YILINUMICH/SRFM/firmware/variants/Seeed_XIAO_nRF52840/README.md

Board variant for the Seeed XIAO nRF52840, copied unchanged from
Seeed-Studio/Adafruit_nRF52_Arduino (`firmware/variants/Seeed_XIAO_nRF52840`, core 1.1.13).

PlatformIO's nordicnrf52 platform has no XIAO definition and its Adafruit
core package has no XIAO variant, so the pin map lives here and
`firmware/boards/xiao_nrf52840.json` points `build.variants_dir` at this directory.
