YILINUMICH/SRFM/hardware/SRFM_PCB/Gerber_V1.1_2026-09-11/How-to-order-PCB.txt

How to Order PCB

Please refer to:
https://prodocs.easyeda.com/en/pcb/order-order-pcb/index.html
