YILINUMICH/SRFM/(commit log)

2026-08-12 Initial commit: Mega 2560 + LTC2668 EVM pressure/vacuum regulator controller
    - Self-contained LTC2668 SPI driver (±10V SoftSpan, SDO echo verification)
    - PressureControl layer mapping 1 air + 3 vacuum regulators to DAC ch 0-3
    - Serial command protocol (ID/P/V/CAL/GET/ZERO) at 115200 baud
    - tkinter GUI over pyserial with per-regulator sliders and ZERO ALL
    - README + HANDOFF docs; DC2025A datasheet/manual PDFs in lib/LTC2668
2026-08-12 Set real regulator calibrations: ITV0030-3BL (air) and ITV2090-312L5 (vacuum)
    Both take 0-10 VDC command signals. Air: +1..+500 kPa; vacuum: -1.3..-80 kPa
    per SMC datasheets. Updated firmware defaults, GUI slider ranges, and docs.
2026-08-12 Fix DAC span mismatch and add raw-DAC debug commands
    The firmware programmed the +/-10V SoftSpan while the board's MSPx
    jumpers (JP4 = 0) lock the LTC2668 into a fixed 0-10V span, so the span
    command was silently ignored and every output landed 1.5x high: a
    commanded 5V measured 7.5V. The boot "safe state" was worse than
    cosmetic -- setVoltageAll(0.0) computed mid-scale code 32767, driving
    all 16 channels to ~5V and commanding the air regulator to ~250 kPa on
    every reset and reflash.
    Switch to LTC2668_SPAN_0_TO_10V. That is the span the jumpers select and
    the input both regulator models accept (ITV0030-3BL and ITV2090-312L5
    are both 0-10V types, per the -3.. suffix). Code 0 is now a true 0V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
    [main.cpp]
2026-08-12 GUI: drop sliders, stack panels, add presets and voltage entry
    Reworks the control panel around bench use rather than dragging:
    - Remove the sliders. Imprecise for setting a pressure and they needed
    drag-throttling to avoid flooding the serial port.
    - One panel per row instead of a 2x2 grid, so each panel is full width
    and the range line is readable. Ranges print in calibration order
    (value at 0V, then at 10V) rather than sorted, so the vacuum ranges
    read -1.3 .. -80 kPa directly against the DAC voltage beside them.
    - Preset buttons per regulator, labelled with unit and the command
    voltage the firmware will program. The voltage comes from a
    voltage_for() that mirrors setPressu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
    [pressure_gui.py]
2026-08-12 README: correct the jumper table and document the raw DAC commands
    JP4 (MSP2) is 0, not 1, so the MSPx pins are not all 1 and the part is
    not in SoftSpan — it is in a fixed manual span where SPI span commands
    have no effect on the hardware. The table said the opposite, and the
    paragraph under it warned about exactly the condition the board is
    actually in.
    Record the span as established by measurement rather than by decoding
    the jumpers: a commanded 5V measured 7.5V at VOUT0, which is only
    consistent with a 0–10V span. Note the trap that follows from fixed
    mode, where SPAN silently changes only the driver's conversion math.
    Also bring the protocol section up to date with the firmware: s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
2026-08-12 GUI: run long-duration tests from a JSON profile
    Adds a Script… button that loads a JSON test profile and steps through it
    unattended, so a multi-hour soak can be defined once and replayed instead
    of being clicked out by hand.
    A profile is a list of steps, each holding a set of setpoints for a given
    number of seconds, optionally repeated. A step entry addresses either the
    pressure layer ({"reg": 0-3, "kPa": ...}) or a DAC channel directly
    ({"ch": 0-15, "volts": ...}), so raw channels can be driven in the same
    sequence. Two examples ship in gui/profiles/.
    Design notes:
    - The whole file is validated before the run starts, setpoints included
    and checked against each regulator's calibrate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
2026-08-12 GUI: document the profile format, fix reader-thread crash on close
    Running quick_check.json against the Mega surfaced a shutdown bug that
    predates the profile work: closing the port while the reader thread is
    blocked in readline() dumps a traceback.
    pyserial's win32 backend tears down _overlapped_read as close() runs on
    the main thread, so the in-flight read raises AttributeError from inside
    pyserial rather than the SerialException the loop was catching. Catch it,
    and add a _closing flag so the thread exits quietly on a deliberate
    disconnect instead of racing the teardown.
    Also coalesce status refreshes. Every P/V ack queued its own GET, so a
    profile step setting four regulators produced f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
    [pressure_gui.py]
2026-08-12 README: add a Deployment section with the setup commands
    The README explained the hardware well but never said, in one place, how
    to go from a checkout to something running. Adds a Deployment section
    after the DAC channel assignment covering the four steps in order:
    install the tools, build and flash, confirm over the monitor, start the
    GUI.
    Folds in the old Build & flash section rather than leaving two places
    that say how to compile, and drops the duplicate pip line from the GUI
    section so installation is documented once.
    Includes the two traps that actually cost time on this bench: a
    charge-only USB cable enumerates nothing and looks exactly like a dead
    Mega, and the serial monitor has t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
2026-08-12 GUI: per-valve CLEAR button, copyright line
    CLEAR sits next to Set on each panel and drops that one regulator to
    zero, resetting its entries, so a single channel can be released without
    disturbing the other three. It sends the same 0 kPa setpoint as ZERO ALL
    and lets the firmware clamp to the safe end of the range.
    Also adds the project copyright in the bottom-right corner.
    [pressure_gui.py]
2026-08-13 GUI: lay the four regulator panels out side by side
    They were stacked one per row, which made a tall window with a lot of
    empty space either side. Put them in a single row of four columns and
    narrow each panel to suit: presets wrap after three buttons, and the
    range header and the commanded/DAC readback each take two lines rather
    than one wide one. Everything else spans the full width.
    Renders at 1224x577, so it still fits a 1366-wide screen.
2026-09-10 Custom PCB firmware: XIAO nRF52840 + AD5724R DAC + ADS1015 ADC
    New branch for the custom 4-channel valve controller board described in
    FIRMWARE_HANDOFF.md, replacing the Mega 2560 + LTC2668 EVM stack on main.
    Firmware (src/, lib/):
    - AD5724R SPI driver: 24-bit frames, mode 2 (switchable), register readback
    - ADS1015 I2C driver: single-shot, averaged monitor reads with timeout
    - ValveConfig: channel map, code_full_scale, readback gain/enable, pressure
    endpoints, heartbeat timeout and SPI mode in internal flash (CRC, version)
    - main.cpp: boot order from the handoff (CLR release, power-up, range,
    readback proof before the rail), nRF52 watchdog, host heartbeat, eFuse
    FLT latch handling, p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
2026-09-10 Board JSON: add XIAO nRF52840 Sense USB IDs (0x8045/0x0045) so upload auto-detects the port
    Claude-Session: https://claude.ai/code/session_01KaDQVFmY1fveNB5y8a6ZE5
2026-09-10 Bench bring-up: verified channel map, watchdog-safe DFU entry, RAWGET/DFU commands
    Board on the bench 2026-09-10 (assembled SRFMV1, XIAO nRF52840 Sense):
    - SPI proof passed in mode 2 (power control reads 0x001F); ADS1015 ACKs.
    - Channel map from the SRFMV1 netlist (added under SRFMV1/) and confirmed
    with a DMM: CH1..4 = VOUT C, D, B, A / AIN 3, 2, 1, 0. Now the default.
    - CAL MAP swaps outputs between channels so a permutation can be entered.
    - Every DAC output hits its 20 mA clamp at 0.67 V: the netlist shows TVS
    diodes D7-D10 from VOUTx to GND wired forward (pin 2 on VOUT, pin 1 on
    GND), the reverse of D2 on the 24 V rail. Hardware fix pending.
    - The stock bootloader (0.6.1) does not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
    [Drill_PTH_Through.DRL, Drill_PTH_Through_Via.DRL, Gerber_BoardOutlineLayer.GKO, Gerber_BottomLayer.GBL, Gerber_BottomSilkscreenLayer.GBO, Gerber_BottomSolderMaskLayer.GBS, Gerber_TopLayer.GTL, Gerber_TopPasteMaskLayer.GTP]
2026-09-11 DFU entry via flash-backed request; upload hook fixes; ID reports reset reason
    The bootloader clears RESETREAS and the .noinit RAM word does not survive
    the watchdog reset + bootloader pass (reads 0xFFFFFFFF), so the second hop
    of the DFU request is now driven by a LittleFS file (/dfu_req) written
    before the firmware stops kicking the watchdog. `pio run -t upload` from a
    running board is verified working on the bench.
    tools/upload_dfu.py: a zero-second wait never checked for the bootloader
    port; report the ports seen when nothing matches.
    ID gains rst= and bootword= diagnostics; RAMTEST <SOFT|WDT> exercises RAM
    retention across the two reset kinds.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
    [main.cpp, upload_dfu.py]
2026-09-11 Docs: bench status 2026-09-10, verified DFU/upload flow, D7-D10 TVS orientation fault
    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
2026-09-11 HANDOFF: CH3 linearity after the D9 rework (+0.6 % gain, no clamp)
    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
2026-09-11 Bench: ADC map verified by jumper test, RAIL FORCE clears eFuse latch, PINTEST bench command
    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
2026-09-11 GET reports the monitor-pin voltage; GUI shows it and derives the pressure from it
    Firmware: GET adds a fourth field per channel (<monV>V, or n/a) and GET <ch>
    adds monv=. GUI: parses the pair, displays 'x.xxx V (pp.p %) ~ pressure'
    computed from the measured monitor voltage (1 V = 0 %, 5 V = 100 %), and
    shows 'no monitor signal' below 0.5 V instead of an extrapolated pressure.
    Verified on the bench: GET returns the new format.
    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
2026-09-11 GUI: Live plot window, 2x2 strip charts of command vs readback voltage per channel
    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
2026-09-11 100 Hz monitor streaming, automatic CSV recording, typed-pressure snapping
    Firmware: STREAM <hz> (0-200, 0 = off) emits "~<ms> <GET body>" once per
    period on the board's own clock; the ADS1015 driver gets a selectable data
    rate and streaming runs it at 3300 SPS with 2 samples averaged (~4.4 ms per
    four-channel sweep). Housekeeping hands its monitor sweep and per-channel
    checks to the stream tick while streaming; LINKLOST clears the stream.
    STATUS reports stream=<hz|off>. Off, the path is unchanged (1600 SPS, 8 avg).
    GUI: "Stream 100 Hz" checkbox (default on) asks for STREAM and keeps the
    link alive with HB; stream lines feed the panels (10 Hz redraw), the plot
    (4 Hz redraw, 60 s x 100 Hz hi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
    [main.cpp, pressure_gui.py]
2026-09-11 Group the repo by kind and bring the README up to date
    Root now holds README.md and platformio.ini only. firmware/ takes src, lib,
    boards, variants, linker and tools; hardware/ takes the SRFMV1 fab files
    and the SMC datasheets (out of lib/); docs/ takes the three handoff and
    protocol documents; gui/ takes its own requirements.txt; data/ is the
    recording folder (ignored). platformio.ini gets a [platformio] section
    pointing src_dir / lib_dir / boards_dir at firmware/, and the board JSON's
    variants_dir and ldscript move with it. All path references in the docs,
    comments and the upload hook are rewritten; clean `pio run` succeeds.
    README: bench status now reflects the D7-D10 rework, the measure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
    [Drill_PTH_Through.DRL, Drill_PTH_Through_Via.DRL, Gerber_BoardOutlineLayer.GKO, Gerber_BottomLayer.GBL, Gerber_BottomSilkscreenLayer.GBO, Gerber_BottomSolderMaskLayer.GBS, Gerber_TopLayer.GTL, Gerber_TopPasteMaskLayer.GTP]
2026-09-11 Hardware: PCB V1.1 with D7-D10 the right way round
    Replaces hardware/SRFMV1/ (the V1 fab files the assembled board was built
    from) with hardware/SRFM_PCB/: V1.1 Gerbers (folder and fab-ready zip),
    the 2026-09-11 netlist and the EasyEDA project. In V1 the output TVS
    diodes D7-D10 sat forward-biased from VOUTA-D to ground and clamped every
    DAC output at ~0.67 V; the assembled V1 board was reworked by hand. V1.1
    has pin 1 on VOUTA-D and pin 2 on GND, matching D2 on the 24 V rail.
    The channel map is unchanged (VOUTC->R18->CMD1, VOUTD->R19->CMD2,
    VOUTB->R20->CMD3, VOUTA->R21->CMD4; RD1..4 -> AIN3..0), so the firmware
    default CDBA/3210 stands. Doc and comment references now point at the new
    folde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
    [Drill_PTH_Through.DRL, Drill_PTH_Through_Via.DRL, Gerber_BoardOutlineLayer.GKO, Gerber_BottomLayer.GBL, Gerber_BottomSilkscreenLayer.GBO, Gerber_BottomSolderMaskLayer.GBS, Gerber_TopLayer.GTL, Gerber_TopPasteMaskLayer.GTP]
